LostV/diy-sound-mixer/docs/handleliste-senere.md

# Handleliste – senere eksperimenter

Ikke en del av første runde. Det her er til når prototype A fungerer og vi vil prøve andre skjermvarianter. Se [hardware-alternativer.md](hardware-alternativer.md) for detaljer og [handleliste-prototype.md](handleliste-prototype.md) for det som kjøpes nå.

Prisene ble sjekket 2026-10-22 og er veiledende.

## Variant B2 – 4 runde farge-LCD-er (én per kanal)

| # | Produkt | Ant. | Ca. pris | Hvor |
|---|---|---|---|---|
| 1 | 1.28" rund LCD-modul GC9A01 240×240 (SPI), én per kanal (Spill, Media, Chat, Mic) | 4 | ~$8–10 stk. | Søk "1.28 inch Round LCD Module GC9A01" på [elecrow.com](https://www.elecrow.com/) ([samme modul hos RobotShop EU](https://eu.robotshop.com/products/elecrow-128-inch-round-lcd-module-gc9a01-240x240-lcd-display)) |
| 2 | Waveshare ESP32-S3-DEV-KIT-N16R8 (driver de 4 skjermene) | 1 | 179 SEK | Søk "ESP32-S3-DEV-KIT-N16R8" på [electrokit.com](https://www.electrokit.com/) |
| 3 | Kopplingsdäck 840 anslutningar (ett ekstra brett, siden ESP32-S3-kortet er så bredt at det trenger to brett side om side) | 1 | 69 SEK | Electrokit art.nr. **10160840** |

**Ca. 550–700 kr.** Encodere, knapper og kabler gjenbrukes fra prototype A.

## Variant B1 – 4× OLED (svart/hvit)

| # | Produkt | Ant. | Ca. pris | Hvor |
|---|---|---|---|---|
| 1 | 1.3" OLED 128×64 (SH1106/SSD1306), **SPI-versjon** (ikke I2C) | 4 | 30–50 kr stk. | AliExpress: [søk](https://www.aliexpress.com/w/wholesale-1.3-oled-spi-sh1106.html) |
| 2 | ESP32-S3 DevKit (samme som B2, kan deles) | 1 | 179 SEK | Electrokit |

**Ca. 120–200 kr** hvis ESP32-S3-kortet allerede er kjøpt til B2.

## Variant B3 – 4× ferdig knott med skjerm i

| # | Produkt | Ant. | Ca. pris | Hvor |
|---|---|---|---|---|
| 1 | Elecrow CrowPanel 1.28" HMI ESP32 Rotary Display | 4 | ~$29 stk. | [elecrow.com](https://www.elecrow.com/crowpanel-1-28inch-hmi-esp32-rotary-display-240-240-ips-round-touch-knob-screen.html) |
| 2 | Liten USB-hub, 4 porter (til inni kabinettet) | 1 | 80–150 kr | – |

**Ca. 1 400–1 600 kr.** Tips: kjøp 1 stk. først for å kjenne på følelsen før du kjøper 4.
