LostV/diy-sound-mixer/docs/concept/black.png

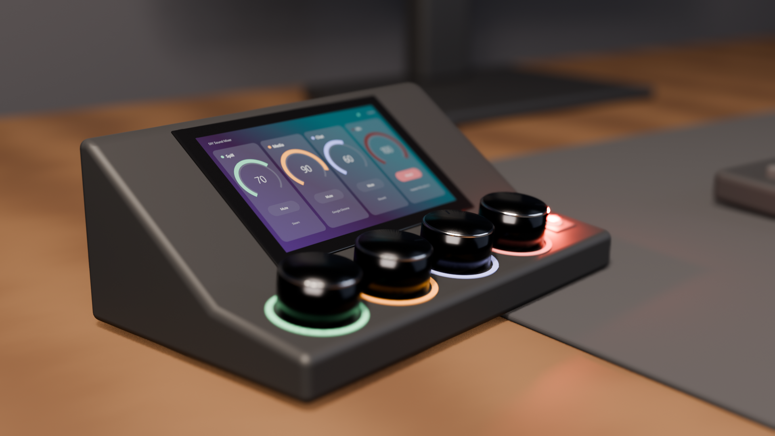
docs/concept/black.png
