LostV/diy-sound-mixer/docs/concept/white.png

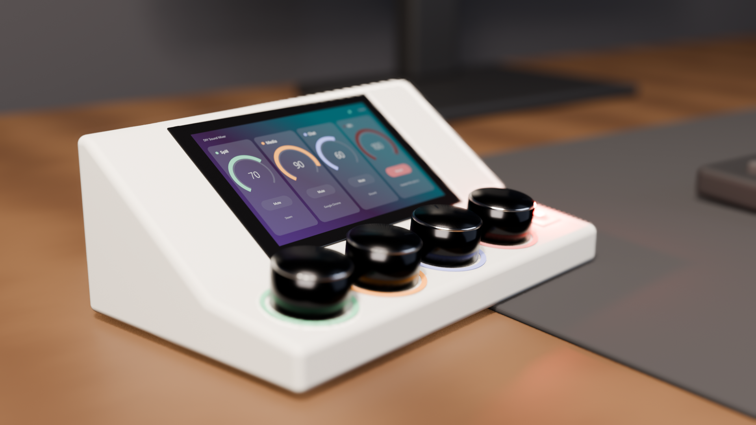
docs/concept/white.png
