LostV/diy-sound-mixer/docs/design/A2-frost-kantlys.png

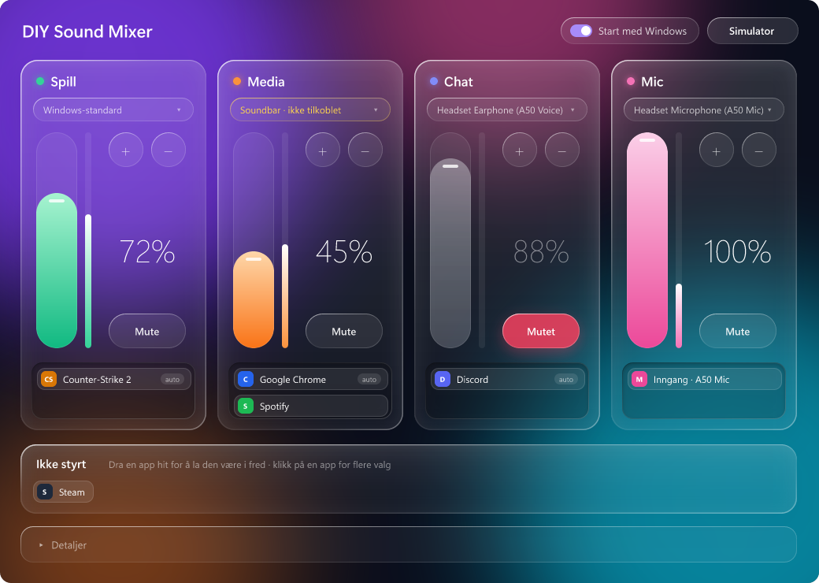
docs/design/A2-frost-kantlys.png
