LostV/diy-sound-mixer/docs/design/A-frost-mork.png

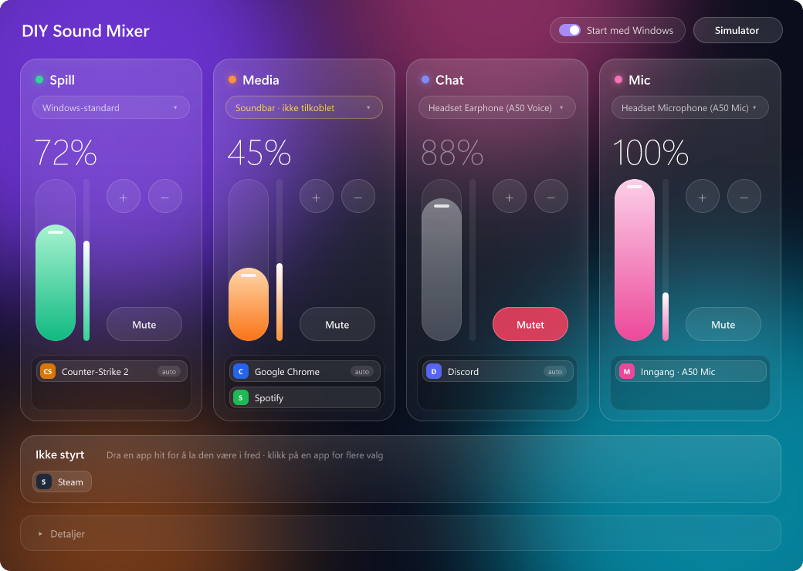
docs/design/A-frost-mork.png
