LostV/diy-sound-mixer/docs/design/app-A2-acrylic.png

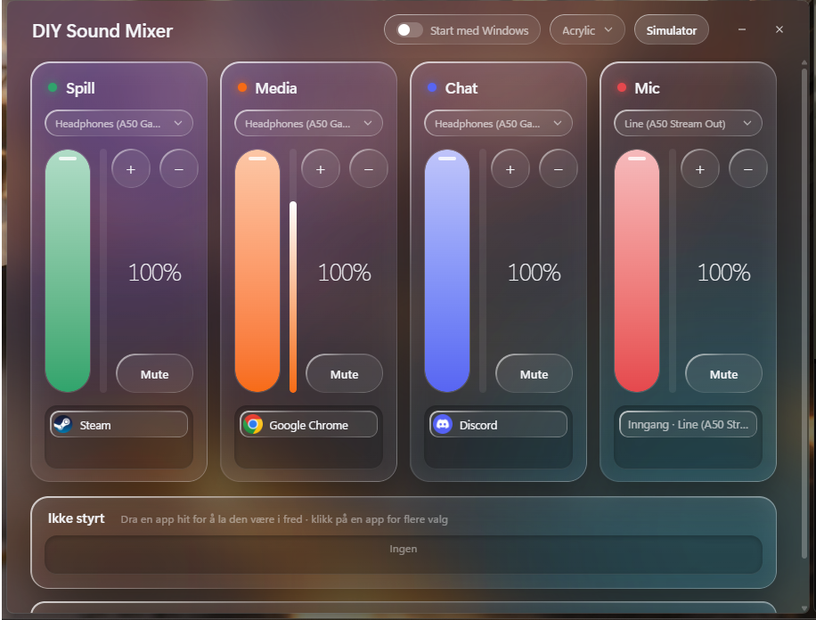
docs/design/app-A2-acrylic.png
