LostV/diy-sound-mixer/docs/design/B-frost-lys.png

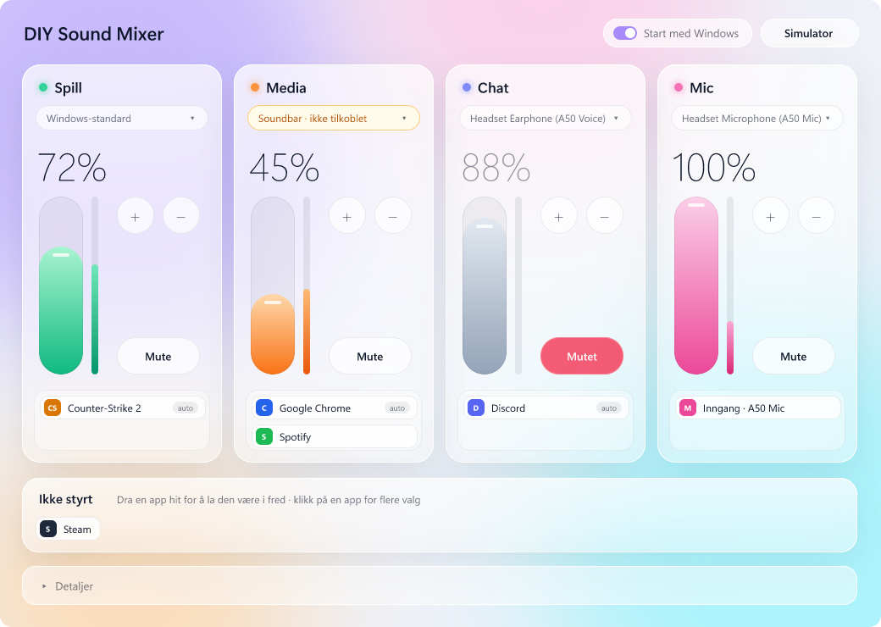
docs/design/B-frost-lys.png
