LostV/diy-sound-mixer/docs/design/C-sonar-inspirert.png

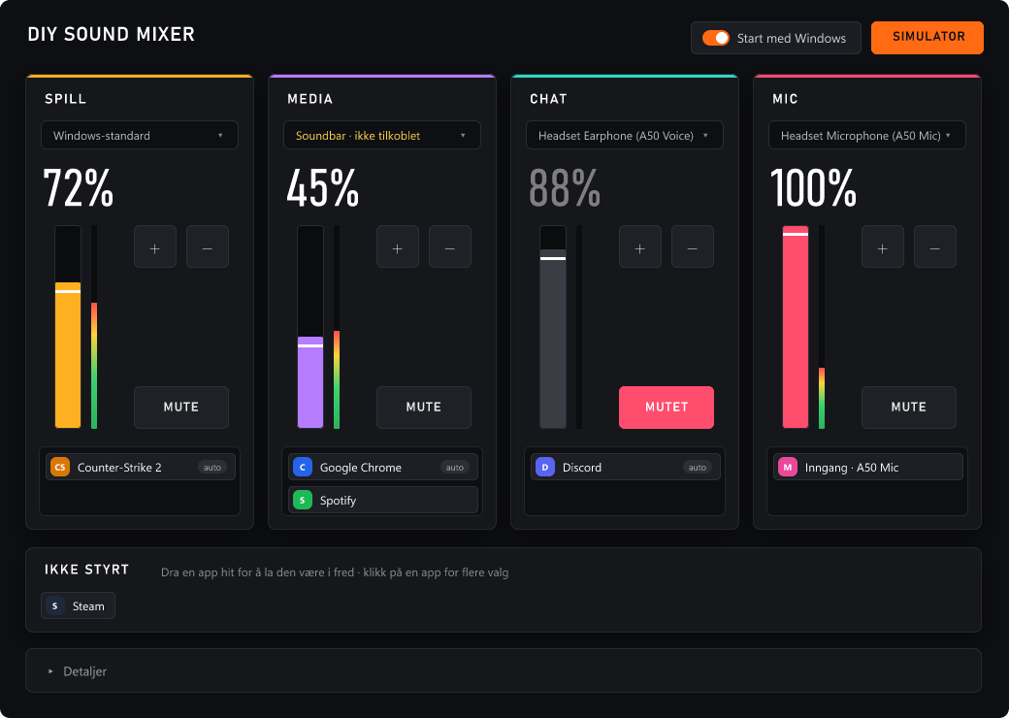
docs/design/C-sonar-inspirert.png
