LostV/diy-sound-mixer/docs/design/D-frost-ringer.png

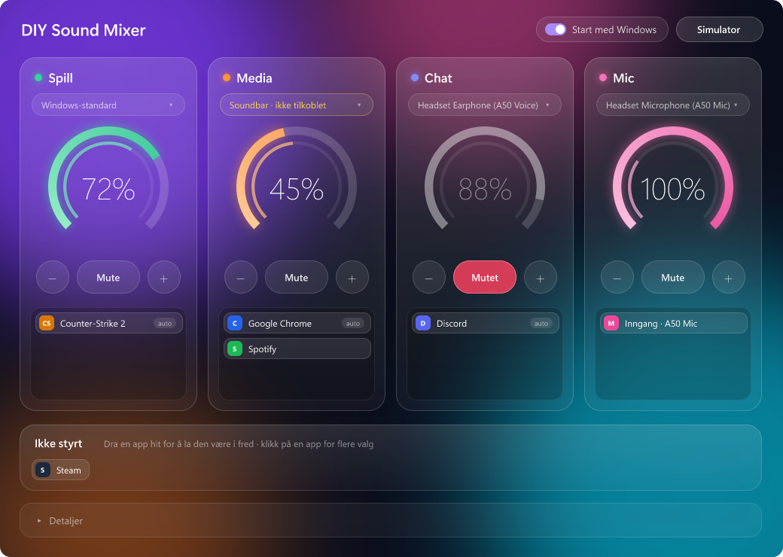
docs/design/D-frost-ringer.png
