LostV/diy-sound-mixer/docs/design/panel-apps.png

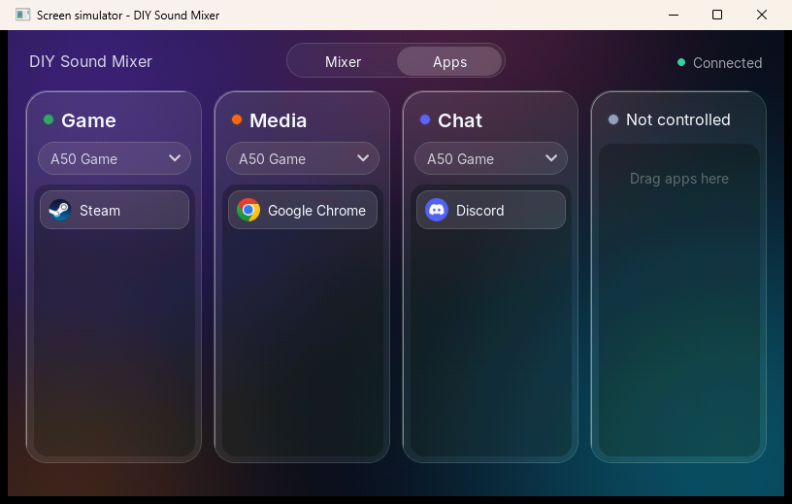
docs/design/panel-apps.png
