LostV/diy-sound-mixer/docs/design/panel-sim.png

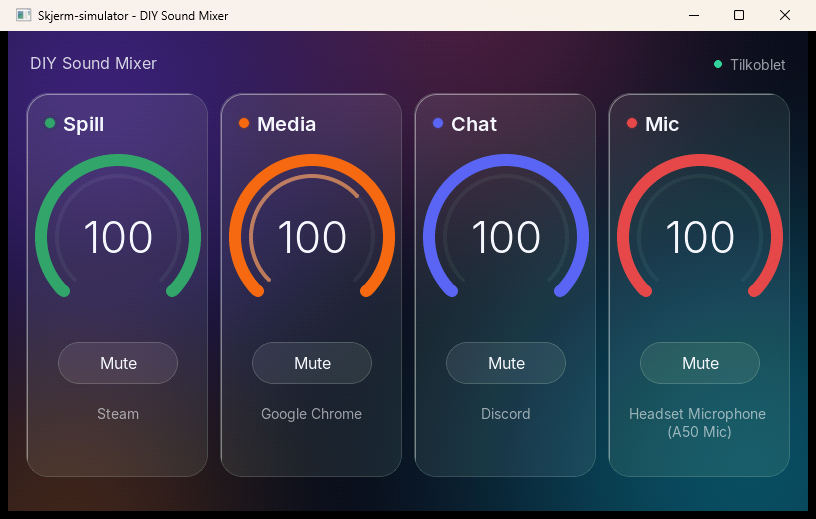
docs/design/panel-sim.png
