LostV/diy-sound-mixer/enclosure/shell/assembly.step

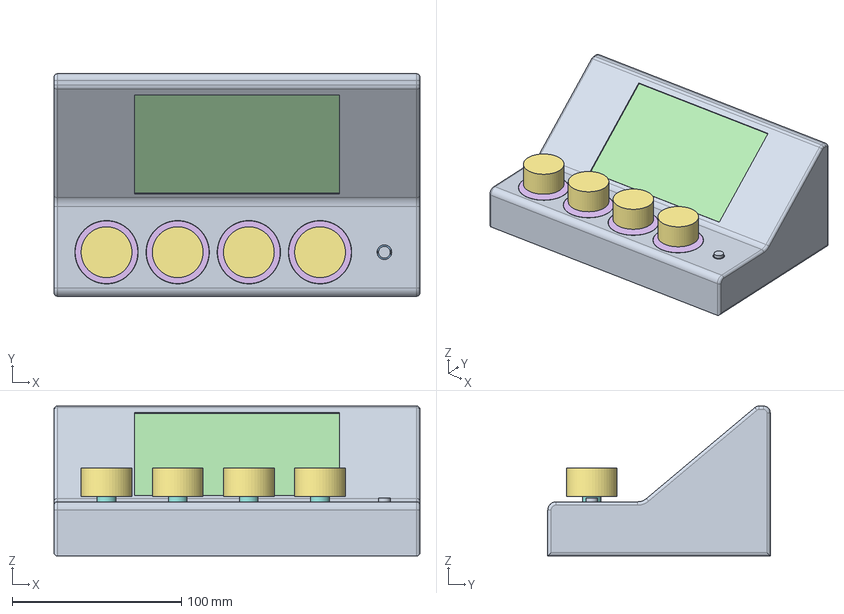
[picture p17: CAD file, 2026-11-03]
enclosure/shell/assembly.step
216.0 x 131.3 x 88.5 mm
