LostV/diy-sound-mixer/enclosure/knob/knob.step

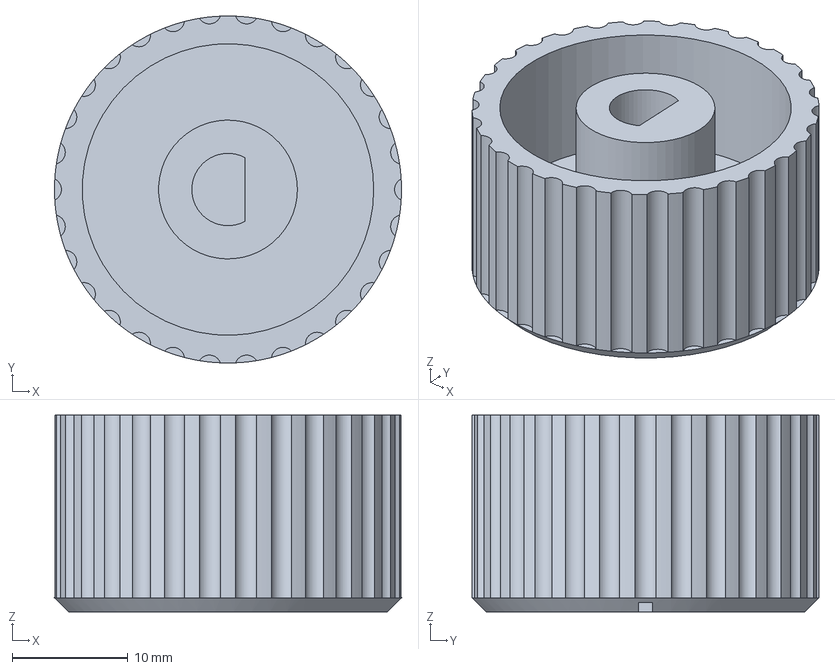
[picture p18: CAD file, 2026-11-01]
enclosure/knob/knob.step
30.0 x 30.0 x 17.0 mm
