LostV/diy-sound-mixer/enclosure/shell/screen-frame.step

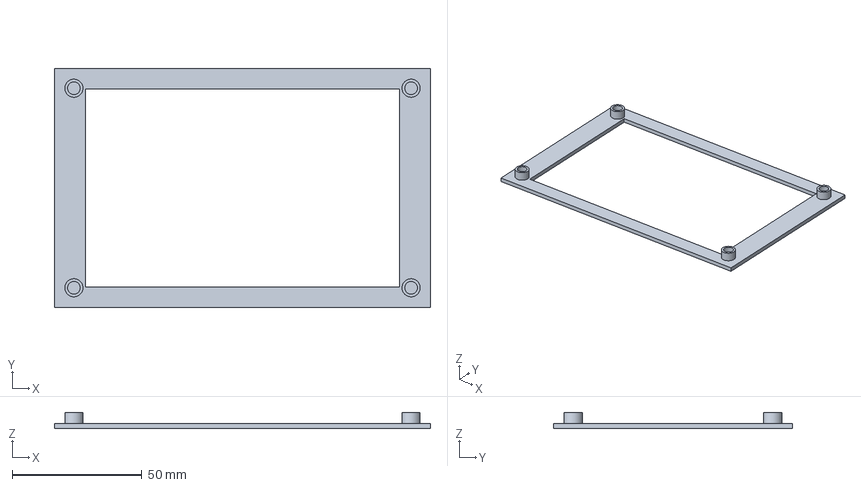
[picture p19: CAD file, 2026-11-03]
enclosure/shell/screen-frame.step
145.0 x 92.0 x 6.30 mm
