LostV/diy-sound-mixer/enclosure/testplate/button-bar.step

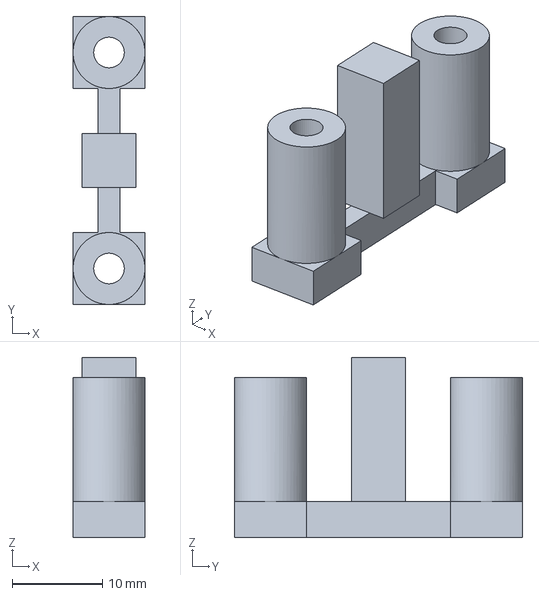
[picture p20: CAD file, 2026-11-01]
enclosure/testplate/button-bar.step
8.00 x 32.0 x 20.0 mm
