LostV/diy-sound-mixer/enclosure/shell/bottom.step

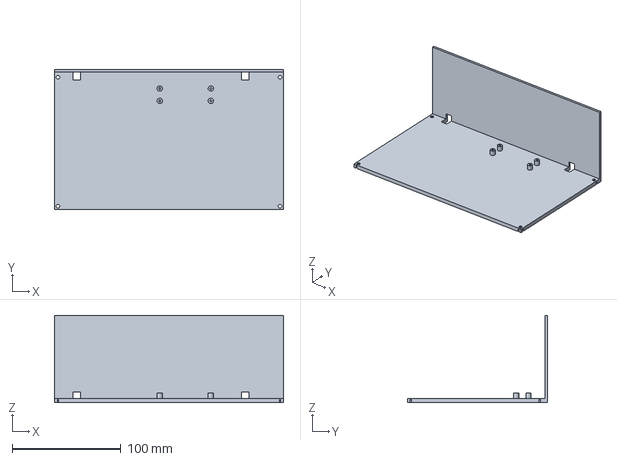
[picture p21: CAD file, 2026-11-03]
enclosure/shell/bottom.step
210.6 x 129.0 x 80.3 mm
