LostV/diy-sound-mixer/enclosure/testplate/testplate.step

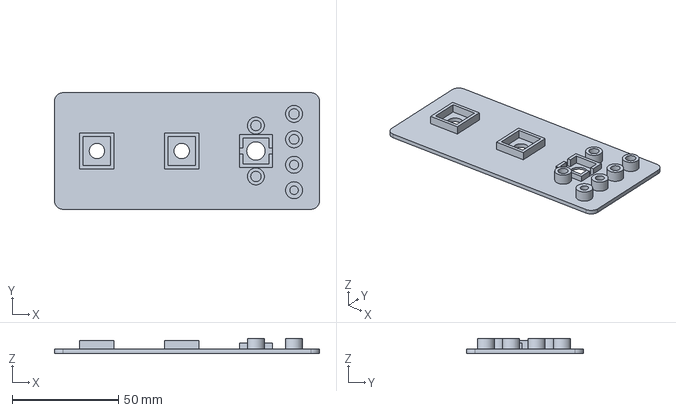
[picture p22: CAD file, 2026-11-01]
enclosure/testplate/testplate.step
125.0 x 55.0 x 7.00 mm
