LostV/diy-sound-mixer/enclosure/shell/ring.step

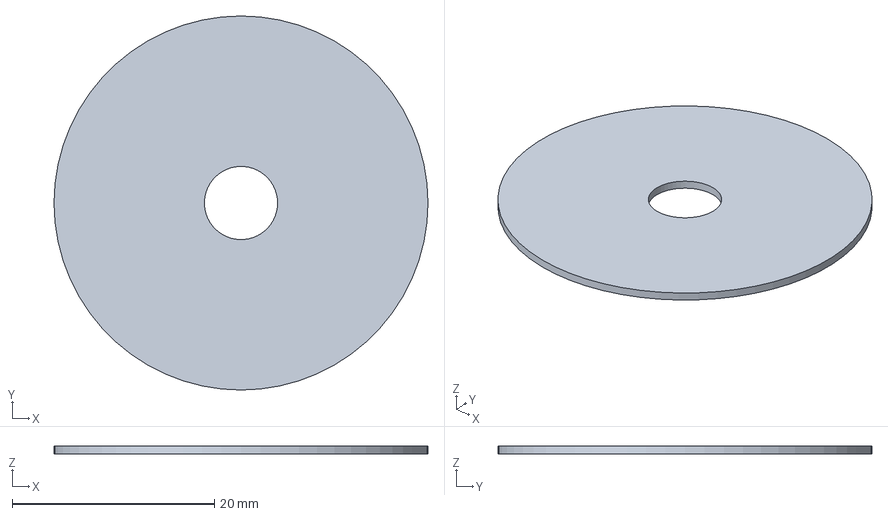
[picture p23: CAD file, 2026-11-03]
enclosure/shell/ring.step
37.0 x 37.0 x 0.8 mm
