LostV/diy-sound-mixer/enclosure/shell/shell.step

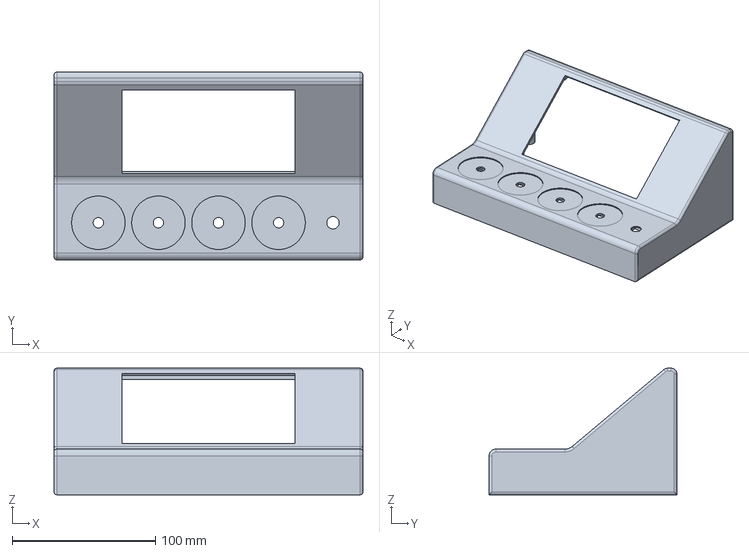
[picture p24: CAD file, 2026-11-03]
enclosure/shell/shell.step
216.0 x 131.3 x 88.5 mm
