LostV/diy-sound-mixer/(list of files, cad)

Other CAD files:
enclosure/knob/knob.stl
enclosure/shell/bottom.stl
enclosure/shell/ring.stl
enclosure/shell/screen-frame.stl
enclosure/shell/shell.stl
enclosure/testplate/button-bar.stl
enclosure/testplate/testplate.stl
