LostV/diy-sound-mixer/(commit log)

2026-10-22 Add PC app phase 0-1: Rust/Tauri audio engine and test window
    - mixer-core: channels (Spill/Media/Chat/Mic), app rules by process name
    and path, per-channel volume/mute, mic mirroring with device choice,
    config persistence and a host thread delivering ~30 Hz snapshots
    - mixer-wasapi: Windows Core Audio backend over all output devices, plus a
    read-only scan example
    - Tauri 2 app with a test window: sliders, encoder-style steps, mute,
    meters, per-app channel assignment and mic picker
2026-10-22 Add phase 2: tray, autostart, device protocol v1 and hardware simulator
    - mixer-devices: protocol v1 (JSON lines) and a device hub that maps
    encoders, buttons and touch to mixer commands and sends only changed
    channel state, LEDs and dB-scaled meters back
    - Tauri app: tray menu (open, simulator, autostart, quit), close hides to
    tray, single instance, autostart starting minimized
    - Simulator window: 800x480 screen mock, four knobs (wheel/drag/keys),
    mute keys with LEDs and a protocol log, speaking the same protocol as
    the hardware will
    - protocol/README.md: spec for the Pico and CrowPanel firmware
2026-10-22 Measure per-app levels with process loopback capture
    Windows' session meters reported the whole A50 Game device's level for
    every active session, so Discord's meter followed Chrome's music. Each
    app with an active session now gets a loopback capture of its own audio
    (Windows 10 2004+), and the peak is computed from that; the session meter
    remains a fallback when loopback is refused.
    Also adds a read-only `meters` example that prints live levels per app.
2026-10-22 Add drag-and-drop app chips and per-channel output device
    - App chips with real icons in each channel; drag between channels and
    "Ikke styrt", or use the click/keyboard menu. "auto" marks rule-placed
    apps; "Automatisk (regler)" unlocks them again
    - Output picker per playback channel, and the mic picker moved into the
    Mic card
    - Per-app routing through Windows' internal IAudioPolicyConfigFactory
    (as Windows Settings, EarTrumpet and SoundSwitch do), trying both known
    interface ids; unknown versions just hide the picker
    - Survives driver and Windows updates: devices are stored by name and id
    and found again by name when the id changes or Windows renumbers them;
    routing is re-appli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
2026-10-22 Add edge-lit frosted glass design (A2) with Acrylic window
    - Design concepts made in FigCraft (docs/design): frost dark/light,
    Sonar-inspired, rings, and the chosen A2 edge-lit glass
    - Transparent window with Acrylic by default; Mica or our own aurora
    background selectable in the title bar and remembered
    - Custom title bar (drag, minimise, close to tray) instead of the system
    frame, so the glass reaches the edges
    - Edge-lit glass on cards, buttons, pickers and chips; custom vertical
    fader with pointer and keyboard control; value moved to the middle
    column and scaled to fit narrow windows
    - Frost kept light (14 px card blur, 24% tint) since Acrylic already
    blurs the desktop
    - The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
2026-10-22 Fix simulator opening as a blank, unclosable window
    show_simulator was a synchronous command, and creating a window from one
    deadlocks on Windows: the command runs on the thread that has to build
    the window. Making it async fixes the button; the tray menu was fine.
    [lib.rs]
2026-10-22 Add phase 3: LVGL screen UI with desktop simulator over TCP
    - firmware/panel-esp32: the 800x480 screen in LVGL 9 (design A2 glass
    cards, channel rings with inner meters, mute pill), shared protocol code
    (ArduinoJson) and an SDL2 desktop simulator built with CMake
    - Inter fonts with Latin-1 (aeoe/aa) generated by fonts/gen-fonts.ps1 (OFL)
    - Aurora background computed once into an RGB565 image with ordered
    dithering; LVGL shadows/gradients banded in 16-bit colour
    - PC app: devices can connect over local TCP (127.0.0.1:47800) and speak
    the same line protocol as USB serial will
2026-10-22 Add single-color emblem SVG for app icon and printed shell
2026-10-22 Add English and Norwegian with a language switcher
    The language lives in the mixer config and follows the Windows language
    on first start. The main window, tray menu and simulator are translated,
    built-in channel names follow the language (Game/Spill) while custom
    names are kept, and the screen gets its own texts through a new `lang`
    protocol message.
2026-10-22 Add touch app page: drag apps between channels and pick devices
    - Screen gets Mixer/Apps tabs. On the apps page, long-press an app, drag
    it to another channel or "Not controlled" and let go; a short tap opens
    a menu (channels, not controlled, automatic). Each channel has an output
    picker, and the mic card a microphone picker
    - Protocol: icon, apps and devices (PC -> panel only) and assign/device
    (panel -> PC); ch gains cap for the mic channel. All additions are
    backward compatible
    - Hub builds the app list, sends real app icons once per link as 24x24
    RGB565A8, and maps assign/device to the same mixer commands the
    desktop app uses
    - Simulator: PANEL_SIM_INPUT test hook drives a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
    [icon.rs, lib.rs, main.cpp, mixer_ui.h, panel_protocol.cpp, panel_protocol.h]
2026-10-23 Stop volume lagging behind the fader
    Windows takes 70-130 ms per SetMasterVolume on some devices (Astro A50),
    and an app like Chrome has many sessions. On the mixer thread that froze
    the meters and made a fader drag play back for half a minute.
    Session volume and mute now go to a writer thread that only keeps the
    newest value per session, and the mixer loop takes every queued command
    before its next refresh.
2026-10-23 Let dev builds run next to the installed app
    Debug builds use their own identifier (so their own config and webview
    data, and single-instance no longer folds them into the installed app),
    listen for devices on port 47801 and say "(dev)" in the window title.
    [lib.rs]
2026-10-23 Compact acrylic mixer window that fits the 1440p slot
    Flat solid channel cards with knob numbers and see-through tinted faders,
    value, steps and mute beside the fader, a slim "Not controlled" bar, and
    the window settings moved into a popover. Fits 905×690 and the 760×560
    minimum without scrolling.
2026-10-25 Write session volume only to playing sessions and only when it changed
    Every SetMasterVolume costs Windows ~0.5 s and, on this machine, ~60 MB
    of kernel ETW memory that takes minutes to free, so a fader drag on a
    channel with many idle sessions could add gigabytes. Idle sessions now
    keep their volume and mute until they start playing (flushed on exit),
    and the writer skips values Windows already has. A 10-step drag over 8
    sessions went from 6.5 s / 178 MB to 1.1 s / 111 MB.
    Adds a probe example to stress and measure these calls.
    [lib.rs, writer.rs]
2026-10-27 Release last scan's sessions before enumerating again
    Calling GetSessionEnumerator while still holding sessions from the
    previous enumeration leaks about 1 KB per held session per call in
    Windows' audio client code. The mixer rescans twice a second, so it grew
    by ~0.7 MB a minute for as long as it ran. Clearing the held sessions
    first keeps memory flat.
    The probe example gains backend, hold and call modes to measure this.
    [lib.rs]
2026-10-31 Add knob firmware for the Pico 2 W and the breadboard test guide
    The Pico reads 4 encoders with push, 4 mute buttons and drives 4 mute
    LEDs, speaking protocol v1 over USB serial. It is built with arduino-cli
    and the Arduino-Pico core. The code lives in knobs.cpp rather than the
    .ino, because the Arduino preprocessor writes prototypes above the types
    they use.
    The 41017819 encoders count backwards when wired as drawn, so REVERSE is
    on. Test 1 passed on the breadboard: all 4 knobs count each click once in
    the right direction, and pushes, mute button 0 and mute LED 0 work.
    The guide (Norwegian) walks through the breadboard hole by hole, with a
    schematic and a breadboard drawing.
    Co-Authored-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
    [knobs.cpp]
2026-10-31 Use one mic-mute button instead of four mute buttons
    Each channel already mutes with a push on its knob, and later with a tap
    on the screen, so separate mute buttons per channel only add holes and
    wiring. The red LED switch stays as a dedicated mic-mute button: it can
    be hit blind, and its light shows that the mic is off. It is wired as
    mute3 and LED 3, so the firmware needs no change.
    The guide and the breadboard drawing now show the button in A20 and the
    resistor in J16–J25, and record which LED leg is plus.
2026-10-31 Connect to the knob board over USB serial
    A background thread looks for serial ports with the Raspberry Pi USB
    vendor id every second and opens each new one as a device link, raising
    DTR so the Pico starts sending. Unplugging ends the link, and plugging in
    again reconnects. Only known vendor ids are opened, because opening a
    serial port resets many other boards.
    The link handling moves out of the TCP listener into run_link, so serial
    and the simulator share it. Its line reader treats read timeouts as
    quiet, not as a closed link, since serial ports time out whenever the
    device has nothing to say.
    Verified with the Pico on the breadboard against the dev build: the
    knobs change channel volume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
    [lib.rs]
2026-10-31 Add the knob panel test plate and part measurements
    Measured the mic-mute LED button and the encoder with a caliper and drew a
    small test plate from them: two encoder pockets, the LED button with a
    screwed retaining bar, and a row of heat-set insert holes in four sizes.
    [button-bar.step, button-bar.stl, testplate.step, testplate.stl]
2026-10-31 Redesign the panel screen: black theme, clearer mute, roomier app page
    The mixer cards drop the mute button. A muted channel now shows a red
    MUTED in the dial, a dim red ring and a red rim, and the space under the
    dial lists the channel's output device and apps. The aurora background
    and glass cards give way to solid dark cards on black.
    The app page gets taller columns, a counted "Not controlled" column and
    tap-to-move: tap an app, then "Move here" in the target column (or
    "Automatic (rules)" in its own). Hold and drag still works; the move
    menu is gone.
    [mixer_ui.h]
2026-11-01 Bring the in-app simulator in line with the new screen and controls
    The simulator's screen now matches the panel firmware's mixer page:
    black, solid cards, a red MUTED in the dial and the channel's apps
    under it. The controls match the hardware decision: four push knobs
    (push = mute) and one mic mute button with its LED instead of four
    mute buttons.
2026-11-01 Finish the test plate and add the temporary knob and the Blender concept
    The test plate passed: 4.9 mm insert holes, and a button bar that clears
    the dupont plugs. The knob fits the encoder's D-shaft until the
    aluminium knobs arrive. The concept renders the wedge shell in white
    and black; frames and videos stay out of git.
    [button-bar.step, button-bar.stl, knob.step, knob.stl, testplate.step, testplate.stl]
2026-11-01 Draw the final shell around the CrowPanel 5" screen
    A wedge with the knobs and the mic button on a 4 degree deck and the
    screen at 40 degrees behind it. The knob and button details are the
    ones the test plate proved; the screen numbers come from Elecrow's
    drawing of the DLE06050B and are to be checked when it arrives. The
    colour rings are separate parts clamped by the encoder nuts, and the
    script checks that the screen, USB-C plug, encoders, button bar and
    Pico stay clear of the shell.
    [assembly.step, bottom.step, bottom.stl, ring.step, ring.stl, shell.step, shell.stl]
2026-11-03 Add a screen test frame to try the real screen before printing the shell
    [assembly.step, bottom.step, ring.step, screen-frame.step, screen-frame.stl, shell.step]
2026-11-03 Port the panel firmware to the CrowPanel 5" board
    The ESP32-S3 build drives the ST7282 RGB panel and GT911 touch and talks
    protocol v1 over the board's CH340C. The PC app now also opens CH340 ports,
    at 921600 baud with DTR and RTS released so the auto-reset circuit leaves
    the panel running. Fonts move under src/ so arduino-cli compiles them.
    [panel-esp32.ino]
2026-11-03 Write each link's queued lines in one go and drop stale meters
    A flush takes tens of milliseconds on the CrowPanel's CH340, so flushing
    after every line let the queue of 30 meters a second grow until touches
    took minutes to show.
2026-11-03 Write the mic volume off the mixer thread and resync the panel after a gap
    Each mic volume write takes ~0.4 s on the A50 Mic, so turning the mic knob
    froze the mixer thread for seconds. The panel then thought the PC was gone
    and cleared its state, and only the mic card came back. Mic writes now go
    through the session writer (newest value wins, scans report it until
    Windows has it), and the panel sends hello when lines resume so the PC
    resends everything.
2026-11-03 Make the knob deck flat with a soft bend into the screen face
    A 4 degree slope printed as visible layer steps across the deck. The deck
    is now flat at 32 mm and meets the screen face in an 8 mm round.
    [assembly.step, bottom.step, bottom.stl, ring.step, screen-frame.step, shell.step, shell.stl]
2026-11-03 Move the back wall onto the bottom plate as one L-shaped part
    The screen's upper posts had 5 mm of room along the screw axis before the
    back wall, so neither a screwdriver nor the iron for the inserts could
    reach them. With the L off, the shell is open at the back and the bottom
    and all four posts can be reached. The L's back wall slides up behind two
    tabs under the rounded top edge; the cable slots move to its corner.
    [assembly.step, bottom.step, bottom.stl, ring.step, screen-frame.step, shell.step, shell.stl]
2026-11-06 Lay out the Pico pins for the shell and add the soldering guide
    In the shell the Pico lies upside down with USB to the right, so each knob
    now uses the four pins nearest to it and the 15 cm wires reach. Knob 0 is
    far left, and on the old breadboard pins its wires came out about 17 cm.
